jun1okamura/TR-1um_Async_I2C/script/test_i2c_slave_async.py

"""
Functional verification of i2c_slave_async using MyHDL's own event-driven
simulator (no external Verilog simulator available in this sandbox).

A minimal bus-functional master model drives SCL/SDA exactly like a real
I2C master (open-drain wired-AND on SDA) and runs:
  1. write transaction  : S, ADDR+W, ACK, DATA=0xA5, ACK, P
  2. read transaction    : S, ADDR+R, ACK, DATA (slave drives 0x3C), NACK, P
and self-checks addressing, ack/nack and byte values against UM10204
3.1.4-3.1.6.
"""

from myhdl import (Signal, intbv, delay, instance, block, Simulation,
                    traceSignals, StopSimulation, now)

from script.i2c_slave_async_model import i2c_slave_async, STATE_NAMES

SLAVE_ADDR = 0x50
T = 20          # half-bit-period-ish time unit (ns), value is irrelevant
                # for an async design - correctness must not depend on it.

errors = []


def check(cond, msg):
    if not cond:
        errors.append(f"[t={now()}] FAIL: {msg}")
    else:
        print(f"[t={now()}] OK: {msg}")


@block
def testbench():
    rst_n = Signal(bool(1))
    scl = Signal(bool(1))
    sda_master_oe = Signal(bool(0))   # master pulls SDA low when 1
    sda_slave_oe = Signal(bool(1))    # v3: slave pulls SDA low when 0 (active-low,
                                       # matches i2c_slave_async_model.py's sda_oe
                                       # port polarity, design_notes.md section 77.3)
    sda_line = Signal(bool(1))        # resolved open-drain bus value

    tx_data = Signal(intbv(0)[8:])
    rx_data = Signal(intbv(0)[8:])
    rx_valid = Signal(bool(0))
    addr_match = Signal(bool(0))
    rw = Signal(bool(0))
    busy = Signal(bool(0))

    dut = i2c_slave_async(rst_n, scl, sda_line, sda_slave_oe,
                           tx_data, rx_data, rx_valid, addr_match, rw, busy,
                           slave_addr=SLAVE_ADDR)

    @instance
    def bus_model():
        # open-drain wired-AND: line is LOW if either side pulls it low.
        # v3: sda_slave_oe is active-low (0 = slave drives), so it
        # contributes a "drive low" vote when it reads 0.
        while True:
            yield sda_master_oe, sda_slave_oe
            sda_line.next = not (sda_master_oe or (not sda_slave_oe))

    def send_bit(bitval):
        yield delay(T)
        scl.next = 0
        sda_master_oe.next = 0 if bitval else 1   # oe=1 => drive 0
        yield delay(T)
        scl.next = 1
        yield delay(2 * T)

    def recv_bit():
        yield delay(T)
        scl.next = 0
        sda_master_oe.next = 0    # release, let slave (or pull-up) drive
        yield delay(T)
        scl.next = 1
        yield delay(T)
        bit = 1 if sda_line else 0
        yield delay(T)
        return bit

    def send_ack(ack):
        # master, as receiver, drives ack(0)/nack(1)
        yield delay(T)
        scl.next = 0
        sda_master_oe.next = 1 if ack == 0 else 0
        yield delay(T)
        scl.next = 1
        yield delay(2 * T)
        scl.next = 0
        sda_master_oe.next = 0

    def send_byte(byte):
        for i in range(7, -1, -1):
            yield from send_bit((byte >> i) & 1)

    @instance
    def master():
        yield delay(5 * T)
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
