jun1okamura/TR-1um_Async_I2C/(commit log)

2026-08-04 非同期I2CスレーブRTLの実バグ2件を修正し、リポジトリを整理
    - src/i2c_slave_async.v: START/STOP検出のレースコンディションを修正。
    start_cond/stop_cond/scl_rise/scl_fallを独立したwire連続代入から
    always内のインライン評価に変更。同じscl/sda_inの変化で起動する
    wireとalwaysの間で評価順序が保証されず、iverilogでalways側が
    遷移前の値を読んでSTART/STOPを検出できないことがあった。
    - src/i2c_slave_async_tb.v: rst_nのリセットパルスが一度も
    発行されていなかったバグを修正。4-state Verilogでは全レジスタが
    Xで起動するため、リセット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
    [i2c_slave_async.v, i2c_slave_async_model.py, i2c_slave_async_tb.v]
2026-08-04 非同期I2CスレーブRTLをゲート合成可能なv2構成へ全面書き直し、Yosys合成と回路図生成まで実施
    - i2c_slave_async.v: 単一always構成（v1）をYosysが合成不能と判定したため、
    非同期SR部（DEL1遅延線+NOR2クロスカップルラッチでSTART/STOP検出）と
    SCL posedge/negedgeドメインのDFFR同期部に分離するv2構成へ書き直し
    - Yosys(yowasp-yosys)でTR1um_5_stdcellへ合成し、i2c_slave_async_net.v
    （33xDFFR+組合せ144セル、ラッチ推論なし）を生成。TR1um_5_stdcell.lib
    （プレースホルダLiberty）を新規追加
    - stdcell_behavioral_stubs.v追加によりiverilogでv2 RTL/netlistを
    シ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
    [i2c_slave_async_net.sch, i2c_slave_async_net_routed.sch]
2026-08-04 - TR1um_5_stdcell.lib の生成スクリプト gen_liberty.py を追加（セルごとの 面積/遅延/論理関数をテーブルで管理、既存libとバイト一致確認済み）
2026-08-05 高FOネットへのバッファ挿入(scl/sda_in/_126_/_127_を分岐×2)、テストベンチの レースコンディション修正、xschem/SPICE接続検証、KLayout配置の再生成を実施
    - fanout_rtl.py/fanout_net.py: RTL・ゲートレベル両方のファンアウト解析ツールを追加
    - insert_buffers.py: scl(BUF_X16x2)/sda_in(BUF_X2x2)/_126_(BUF_X4x2)/_127_(BUF_X2x2)
    を分岐バッファ挿入、i2c_slave_async_net.vを144→152インスタンスに更新
    - lvs_check.py: 新旧ネットリスト間の構造的接続検証ツールを追加
    - テストベンチのレースコンディションを発見・修正: send_bit/read_ack/read_byte/
    send_ack等でsclとm_oe(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
    [i2c_slave_async_net.sch, i2c_slave_async_net_routed.sch]
2026-08-05 上マージンチャネル(論理行3)パイロット配線: V1-GC DRC対応と隣接ピン競合対策
    - V1.GC間隔違反(実機KLayout DRC run.drcで検出、6件)を修正: abs_pin_anchor()の
    ビア安全領域計算にGCレイヤ立入禁止ゾーンの差し引きを追加
    - 隣接ピン(同一/近接インスタンス)によるM2エスケープ競合を8件→2件に削減:
    共有障害物検出+Union-Findグループ化、交互方向(L/R)強制割り当て、
    forced_rank/skip_rankによるオフセット競合回避、優先ネット処理順制御
    - 残り2件は既知の制約として記録(_find_jog_xの早期リターンが原因と特定、
    修正を試みたが密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
2026-08-05 残存2件の対処案としてXミラー反転を試行、効果なく不採用(design_notes.md §22.6)
    - _400_(NOR4)のA pinをXミラーで移動させ短絡回避を試みたが、DRC(M1間隔)違反
    2件が新規発生し、接続検証の短絡疑いも2件→4件に悪化
    - 事前検討でNAND2/AND2_X1/NOR4のA/B(/C/D)ピンがセル内で同一X座標である
    ことをライブラリGDSから確認: 同一インスタンス内競合(_404_等)はXミラー
    では原理的に解決しないことを裏付け
    - 試行はrevert、gen_gds_placement.py・配置GDSはコミット済み版と一致することを確認
    - パイロット配線GDSはDRCクリーン・残存2件の既知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
2026-08-05 同一X pin(A/B縦積み)の強制ジョグ前処理を実装、_404_の短絡を解消(design_notes.md §22.7)
    - 全ピンをX座標で完全突き合わせし、同一Xのペア(_404_/_410_/_430_の各A/B、
    NAND2/NOR4系ゲートの縦積み入力ピンでライブラリ設計上X完全一致が確定)を
    must_jogとしてマーク
    - _find_jog_xに must_jog 引数を追加、該当ピンは「既にクリア」の早期リターン
    を無条件スキップし必ず実ジグザグ探索を行うよう修正
    - §22.5で悪化したpreferred_dir全体への適用と異なり、完全同一X(衝突が数学的
    に確実なケース)のみに範囲を絞ったため副作用なし(DRC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
2026-08-05 論理行0・行1/2共有チャネルの行内配線を実施(design_notes.md §23)
    - route_channel_pilot.pyを汎用化したroute_channel.py(route_row_channel)を
    新設: phys_row_index/mirrored/channel位置/escape_dirをパラメータ化
    (論理行1/2は電源レール共有のためY反転配置、将来の共有チャネル対応を
    見据えmirrored=Trueのピン座標変換(M0)にも対応)
    - 論理行3で回帰チェック(既存パイロットと完全一致)後、論理行0を配線
    (26ネット、DRCクリーン、接続検証残存3件)
    - 一般化作業中、初期スキャンと再スキャンでM2障害物スキャン範囲が
    不一致というバグを発見・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
2026-08-05 FM法による配置最適化でクロス行ネットを73%削減、配置を再生成(design_notes.md §23.5,24)
    - 行をまたぐネットの分析: 107本(電源除く)、うち配線困難なギャップ0境界
    (行0↔1、行2↔3)を含むものが67本と判明
    - route_cross_row.py: ギャップ0境界向けの新配線方式(M2連続シェイプ)を
    試作するも失敗率43%・新規短絡4件と不十分と判明(否定的結果、
    出力GDSはLayout/へコミットせず)
    - plan_placement.pyにFiduccia-Mattheyses法による階層的ハイパーグラフ
    最小カット分割を実装: {行0+1}vs{行2+3}(実チャネルのある行1↔2境界に
    カットを誘導)→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
2026-08-06 FM分割の決定性バグ修正、チャネル高さ拡大、フォールバック汚染バグ修正
    - plan_placement.py: _fm_bipartition()のセット反復をsorted()に変更し
    プロセス間の非決定性を解消(list(set)がハッシュランダム化の影響を受けていた)
    - gen_gds_placement.py: FM最適化後の配置密度に合わせてPHYSICAL_ROWSの
    チャネル高さを拡大(行3上マージン2→4行,行1/2共有3→7行;物理構造の
    シーケンスは維持,行1/2側は奇数を維持してミラー偶奇を保存)
    - route_channel.py/route_channel_shared.py: ROW3_PILOT/ROW12_SHAREDの
    phys_row_index等を新配置に追従。ジョグ探索失敗時に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
2026-08-06 ミラー配置廃止・5行チャネル方式への全面再設計
    物理構造を「配線+スタセル1段+配線」の単位を縦に5個積む方式に変更し、
    上下ミラー配置を全廃(design_notes.md section 26)。旧4行構造では
    行0/行1・行2/行3がゼロギャップのミラー隣接ペア(電源レール共有)で、
    このゼロギャップ境界を跨ぐ配線が最後まで未解決の課題だった
    (route_cross_row.pyの試作は失敗、FM配置最適化でも回避しきれず)。
    新構造は全ての行境界を実M1チャネルにすることでこれを根本解決。
    - plan_placement.py: NROWS=4→5。compute_rows()にnrows==5用の5行
    チェーン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
2026-08-06 6チャネル統合レイアウトを生成、チャネル間の見落とし衝突を修正
    ユーザー要望で全チャネルを1つのGDSにまとめて出力するにあたり、
    各チャネルが独立に配置のみGDSを読んで配線していたため、同じ行を
    挟む隣接チャネル同士が互いの配線結果を見ずに配線し、統合すると
    M2違反19件・ショート疑い52件相当に悪化する問題を発見(design_notes.md
    section 26.8)。
    route_channel.py/route_channel_shared.pyにin_gds引数を追加し、
    route_all_channels.pyで6チャネルを物理的な並び順に逐次配線するよう
    変更: 各チャネルは直前のチャネルの累積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
2026-08-06 上下ミラー配置を全物理行に復活(ウェル系DRC対策)
    ユーザーが実KLayout DRCデックで多数のエラーを確認。§26で「ミラーは
    ゼロギャップ境界の電源レール共有専用で実チャネル方式には不要」と
    判断したのは誤りで、Nウェル/Pウェルのバンディングも上下ミラー交互
    配置を前提にしていた。本セッションの簡易DRCチェックスクリプトは
    M1/M2/V1のみでウェル/タップ層を見ていなかったため検出できていな
    かった。このサンドボックスにはklayout DRC DSLランタイムが無く
    run.drcを直接実行して確認することはできないため、ユ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
2026-08-06 実DRC結果に基づきV1-CO違反を解消、M2違反を7→3件に削減
    ユーザーが実KLayout DRC(tech/drc/run.drc)を実行し、DRC_Error.lyrdb
    を共有。実エラー15件(M2最小間隔違反7件=既知パターン、V1-CO重なり
    8件=簡易チェックスクリプトが検証していなかった新種)に対応。
    - route_channel.py/route_channel_shared.py: via anchor探索にCO層
    (11/0、poly/diffusion-M1間コンタクト)回避を追加(既存のGC層回避と
    同じ仕組み)。V1-CO重なり・1.0um未満分離とも0件に。
    - 同上: ネット単位で一括描画していたのをピン単位でインターリーブ
    (描画直後に_existing_m2を更新)す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
2026-08-06 未配線ピン(88件)解消の試行: 2ベンドZシェイプジョグ実装、根本原因を特定
    route_channel.py/route_channel_shared.pyに2段ベンド(Zシェイプ)の
    ジョグフォールバックを実装。単一ベンド(L字)探索が失敗した場合、
    ピン→トラック間の中間Y(5分割点)でローカル退避→フルレンジ探索の
    2段構えを試す。_find_jog_xを_find_jog_x_range/_find_jog_pathに
    一般化し、ピン単位描画ループを任意長ウェイポイント列に対応させた。
    検証の結果、Zシェイプ経路は1件も使われず、オープン件数は88件の
    まま変化なし。原因を実際の失敗ピン座標とM2形状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
2026-08-06 チャネル振り分けをネット数ベースの貪欲バランスに変更(ch4_tm偏り修正)
    route_all_channels.pyの同一インスタンスグループの割当を、グループ
    個数での交互round-robinから、グループをネット数の多い順にソートし
    逐次少ない方のチャネルへ割り当てる貪欲バランスに変更。
    原因: 論理行4の行内完結ネット45本がUnion-Find(同一インスタンス
    共有による推移的結合)でわずか5グループに収束し、うち1グループが
    37本(82%)を占めていた。グループ"個数"で交互割当していたため、
    この巨大グループが偶数番目(ch3_4側)に丸ごと入り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
2026-08-06 2パス方式のvia anchor予約を実装、M2スペース違反が初めて0件に
    route_channel.py/route_channel_shared.pyに、配線開始前に全ピンの
    via/pad アンカー位置を予約する2パス方式を実装。ジョグ探索の障害物
    判定に、実際に描画済みのM2形状(_existing_m2)に加えて全ピンの予約
    領域(自分自身は除外)を含めるようにし、先着ネットのジョグ経路が
    後続ピンの設置場所を塞ぐことを未然に防ぐ(section 29.4で診断した
    資源競合の根本原因への直接対処)。
    結果: M2スペース違反 4件→0件(section 22.5以来初めて0件を達成)。
    未配線ピンは89→86件と小幅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
2026-08-06 アンカー予約のチャネル横断グローバル化を試行、悪化のためロールバック
    route_channel.py/route_channel_shared.pyの予約対象を、チャネルが
    実際に配線するネットのピン(net_stub_pts)から、行内の全インスタンス
    の全ピン(allowed_netsに関係なく)へ拡張し、チャネル間の見落とし
    衝突(§31残課題の23/86件=27%)の解消を試みた。
    結果、未配線ピンが86→104件に悪化(M2違反は0件を維持)。予約範囲を
    無関係なネットのピンまで大幅に広げたことで、多くのジョグ経路が
    新たに塞がれてしまい、狙った27%の改善を副作用が上回った。
    §31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
2026-08-06 マルチホップネット(15件)向けの最終配線パスを新規実装(route_multihop.py)
    3行以上/非隣接行にまたがりチャネル配線では扱えない15件のマルチ
    ホップネットに対応する新規スクリプトroute_multihop.pyを追加。
    統合済みレイアウト(i2c_slave_async_layout_routed_all.gds)を読み
    込み、各ネットのピンをY順に並べてM2チェーン配線する最終パス。
    単純なエルボー/Zシェイプは100%失敗(チップ全体スケールでは単一
    ベンドが経路上のどこかで必ず衝突する、section 29と同種の限界)。
    15ネット・約100セグメントに限定範囲であることを踏まえ、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
2026-08-06 未配線86ピン・15ネットの詳細レポートとERRレイヤー可視化を追加
    script/gen_err_report.pyを新規実装。route_all_channels.py/
    route_multihop.pyのログから未配線項目を抽出し、以下2点を生成:
    1. Layout/unrouted_report.txt: チャネル内オープンピン86件
    (net名・instance.pin・座標)とマルチホップ未配線セグメント91件
    (net名・対象行・区間・座標)の一覧テキスト
    2. Layout/i2c_slave_async_layout_with_err.gds: メインの
    routed_all.gdsとは別のレビュー用コピーに、ERRレイヤー
    (252/0=チャネルオープンピン、252/1=マルチホップ未配線区間の
    端点・接続線)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
2026-08-07 FO=1ネットのクラスタ配置を実装、単一行構成での効果判定実験を実施・記録
    - plan_placement.py: FO=1(受信ピン1個)ネットの出力/入力セルを
    Union-Findでクラスタ化(上限4)、FM分割・行内順序で常に隣接配置
    されるようにした。クラスタ化に伴いFM容量スラックを1.28→1.05に
    再チューニング。
    - route_all_channels.py: 同一インスタンスUnion-Findグループに
    上限を追加できるSAME_INST_GROUP_CAP機構を追加(本番5行では
    9999=実質無効、単一行実験でのみ16を使用)。
    - 5行構成での結果: チャネルオープン86→42(改善)、マルチホップ
    15→34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
2026-08-07 FILLコリドー除去テストと6行構成試行を記録
    - plan_placement.py: FM分割のnrows!=4,5フォールバックを、汎用的な
    再帰チェーン分割(split_chain)に置き換え。nrows=1(単一行実験)を
    特殊ケースとして自動的に正しく処理しつつ、nrows=6のような任意の
    行数にも対応。
    - gen_gds_placement.py: distribute_row_fillers()にNO_CORRIDORS
    トグルを追加(コリドーなし比較用)、USE_6ROWトグルで6行チェーン
    構造(PHYSICAL_ROWS_6)を再現可能に。どちらも未設定時は本番の
    5行構成に影響なし。
    - 単一行構成でのFILLコリドー効果確認: コリドーありオープン83件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
2026-08-07 チャネル内オープン42件の原因内訳を調査・記録
    - route_channel.py/route_channel_shared.pyにROUTE_DEBUG_CAUSE=1で
    有効化される診断コードを追加。失敗ピンごとに(1)自分のアンカーが
    既存M2/2パス予約で塞がれているか、(2)塞がれていない場合は
    ピン→トラック間の垂直経路のどこが塞がれているかを2um刻みで
    スキャンして報告する。デフォルト無効、本番動作に影響なし。
    - 42件中16件(38%)はアンカー自体が既存M2と衝突(§29.4と同じ
    パターン)、26件は別要因と分類。診断の結果、この26件は例外なく
    「アンカーはクリアだ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
2026-08-07 オープンピン/未接続ネット/接続先をレイヤー分離したERR可視化を追加
    - script/gen_err_report2.py: 最終統合GDSから全196ネットの実接続性を
    M1/V1/M2のUnion-Findで直接再構築し(ログパースではなく)、ネット単位
    で分類:
    - (252,0) オープンピン: ネットは部分的に接続済みだが繋がって
    いないピン。接続先(252,2)は同ネットの本体側最近傍ピン。
    - (252,1) 未接続ネット: ネット内のどのピアも一切繋がっていない
    ネット全体のピン。接続先(252,2)は同ネット内の最近傍ピン。
    - (252,2) 接続先マーカー+接続線(両カテゴリ共通)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
2026-08-07 route_multihop.py: fix pad-drawing to check M2 clearance + guarantee V1-M1 enclosure on offset
    - touched-pin via/M2-pad drawing now checks clearance against a
    per-net snapshot of other nets' M2 (_other_nets_m2) before drawing,
    with a small local-offset retry (0.5-4um) before giving up and
    leaving a pin open (logged as WARNING). Previously drawn
    unconditionally with zero clearance check -- latent bug exposed by
    the 6-row+always-fill trial (6/7 new M2 violations).
    - fix attempt 1 (checked against the live, continuously-updated
    _existing_m2) had a false-positive problem: it also flagged a pin's
    pad as 'colliding' with its own net's just-drawn trunk (intentional
    overlap), causing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
2026-08-07 design_notes.md: document V1-M1 bug fix and 6-row width sweep (section 34.9-34.11); restore production layout regen
    - section 34.9: FILL-always + width-relaxation trial on 5-row
    (2200um: 31 opens/DRC=1, better than 2050um's 31 opens/DRC=9)
    - section 34.10: full root-cause writeup of the route_multihop.py
    unconditional pad-drawing bug, fix attempt 1's false-positive
    regression, fix attempt 2's correct snapshot-based approach, and
    the V1-M1 enclosure violation it initially introduced (offset pads
    need their own M1 guarantee-pad -- the original abs_pin_anchor()
    enclosure guarantee only holds at the pin's un-offset anchor)
    - section 34.11: 6-row + always-fill width sweep with the cor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
2026-08-07 6行+FILL常時挿入(ROW_WIDTH_UM=2075)を作業ツリーに反映しレイアウト確定・ERR可視化
    - plan_placement.py/gen_gds_placement.pyを6行/2075um版に切替
    (5行本番/1800umはコミット履歴6368b13/eb3d17cに保持、必要なら
    そちらのファイルへ戻して再生成すれば復元可能)
    - 全パイプライン再生成 (PYTHONHASHSEED=0, USE_6ROW=1):
    チャネル内オープン29、マルチホップ 0完全/11部分/19完全失敗
    DRC完全クリーン (M1/M2/V1 全項目 viol=0)
    - gen_err_report2.py: 真の接続性再検証
    オープンピン82・未接続ネット120ピン(38ネット)、合計202
    (5行本番の236より良好)
    - gen_err_repor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
2026-08-07 route_multihop.py: switch to M1-in-channel routing model (design_notes.md section 34.12)
    Per user request: inter-cell connections must switch to M1 in the
    channel region before connecting, instead of running M2 directly
    across cell rows.
    - vertical moves: always M2 (crossing a cell row, no electrical
    overlap so no via needed against that row's own M1)
    - horizontal moves: only legal, and only ever drawn, on M1, and only
    while inside a channel band (a filler-only physical row) -- mirrors
    the channel routers' own M1-trunk-at-track-height convention,
    generalized across multiple channels
    - every interior bend in the simplified path is now a genuine M1<->M2
    transition and gets a real vi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
2026-08-07 route_multihop.py: refine M1-channel-switch to FILL-gap-limited M2 (design_notes.md section 34.13)
    Per user refinement: M2 may run horizontally, outside a channel band,
    only as far as the FILL slot immediately next to a cell -- never
    directly over another real cell. Longer connections must go M2
    vertical -> M1 horizontal in a channel band (section 34.12's rule),
    same as before.
    - computed every real (non-filler) cell's absolute X extent from the
    placement data, and the inter-cell FILL gaps between consecutive
    cells in each row (_cell_x_extent, _gap_ranges_by_row)
    - new _h_leg_layer(y, x0, x1): 'M1' if y is in a channel band, 'M2' if
    y is in a cell row and the whole [x0,x1] span stays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
2026-08-07 gen_gds_placement.py: halve underutilized channels ch0_1/ch2_3/ch3_4 (design_notes.md section 34.14)
    Per user observation, route_all_channels.py's own track-usage report
    (section 34.13's 1700um config) showed ch0_1/ch2_3/ch3_4 using only
    7/32, 5/32, 7/32 track slots respectively -- well within a halved
    16-slot budget. ch1_2 (20/32) and ch4_5 (16/32) are used closer to
    capacity and were left at 4 filler rows.
    Result: core height 1650um -> 1320um (-20%), but with a quality
    regression: segments 0/15/15 -> 0/13/17, DRC violations 2 -> 6
    (M1:5,M2:1), true connectivity 195 -> 199. Traced 3 of the 5 new M1
    violations to ch1_2 (a channel whose height was NOT changed) --
    apparently a knock-on effect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
2026-08-07 route_multihop.py: fix unchecked bend-via guarantee-pad placement (design_notes.md section 34.15)
    Per user hypothesis that the M1 space violations came from a
    2um-vs-4um M1 width mismatch between route_multihop.py's legs and the
    channel routers' trunks: investigated the actual violation geometry
    and found the real cause is more direct -- the M1<->M2 layer-
    transition guarantee pad (3.4x3.4um, introduced in section 34.12) was
    drawn completely unconditionally, with no clearance check against
    existing M1 at all, unlike every other pad-drawing site in this
    project (same class of oversight as section 34.10's touched-pin pad
    bug). The pad's own width (3.4um, wider than the 2um leg) made it
    more li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
2026-08-07 route_channel.py/route_channel_shared.py: fix unchecked pin-pad placement (design_notes.md section 34.16)
    Investigated the last remaining M2 violation (x=436,y=562-570) and
    found it predates route_multihop.py entirely -- confirmed via GDS
    diff that all 3 colliding shapes already existed right after
    route_all_channels.py, before route_multihop.py ran at all.
    Root cause: same bug class as sections 34.10/34.15, but in the
    channel routers this time. Each pin's own M2 pad is drawn at a FIXED
    position (the pin's physical location) completely unconditionally --
    the jog PATH is clearance-checked via _find_jog_path, but the pad
    itself is not automatically covered by that search (a neighboring
    pin's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
2026-08-12 design_notes.md: record next-gen stdcell/routing-channel grid policy (section 35)
    Captures the architectural direction discussed for the standard cell
    library redo, based on the user-supplied TR-1um_DRC_summary.pdf:
    - Cell height quantized to 5.4um (shared with M2 vertical track
    pitch), cell width = 5.4um x pin count with one dedicated X track
    per signal pin (no shared X).
    - Channel grid: X=5.4um (M2), Y=4.0um (M1 trunk pitch).
    - All dimensions verified against this project's established DRC
    minimums (M1 1.8/1.4, M2 3.0/2.0, via 1.4, enclosure 1.0) -- the
    via/pad math (1.4 + 2x1.0 = 3.4) already matches route_channel.py's
    existing VIA_SIZE/M2_PAD_SIZE constants exactly.
    - VDD/GND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
2026-08-13 design_notes.md + LEF/script: record next-gen stdcell implementation progress
    - design_notes.md section 35.6: implementation decisions confirmed
    while prototyping INV_X1 -- no row mirroring (replaced by
    channel-cell-channel sandwich placement), via/M2 pads baked into
    the cell but not extended into a full vertical pass-through
    (pin position is computed from the LEF offset table, not searched,
    so no pass-through is needed), and the pin marker layer split into
    M1PIN (48/1) / M2PIN (49/1) to resolve the ambiguity found when a
    single generic 'pin' layer would otherwise mark both the M1 VDD/GND
    rail and an M2 signal pad at overlapping coordinates.
    - design_notes.md section 35.7: sc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
2026-08-13 gen_lef.py: add DFFR pin metadata; regenerate LEF with 14/17 cells
    DFFR GDS added by user (SIZE 64.8x64.8um, matches section 35.8's
    20-transistor TG-based design: D/CK/RST inputs, Q/QB outputs, all on
    M2, CK marked USE CLOCK). Verified clean against the same DRC/pin
    coverage checks used for the other 13 macros (M1/M2 width+space, V1
    enclosure+space, pin-marker-vs-real-geometry coverage) -- all zero
    violations. LEF now covers 14 of the 17 cell types used in the
    synthesized netlist; only BUF_X2/X4/X16 remain.
    design_notes.md section 35.7 updated with DFFR's verification result
    and the shrunk remaining-cells table.
2026-08-13 gen_lef.py: alias BUF_X2/X4/X16 to BUF_X1's physical cell; LEF now covers all 17 cell types
    User drew BUF_X1 and decided not to draw separate physical cells for
    BUF_X2/X4/X16 for now -- substitute BUF_X1's layout for all of them.
    Implemented via LEF's FOREIGN mechanism (MACRO name can differ from
    the GDS structure it references): MACRO BUF_X2/BUF_X4/BUF_X16 each
    declare FOREIGN BUF_X1, so P&R places BUF_X1's real geometry under
    each of the three logical names without any netlist changes. Verified
    BUF_X1 itself clean against the same DRC/pin-coverage checks used for
    every other cell.
    Flagged in code + design_notes.md section 35.7: gen_liberty.py's
    COMB_CELLS table still only defines BUF_X1's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
2026-08-13 gen_lef.py: support multi-fragment pins; add TAP2/TAP3 power tap cells
    User drew TAP2/TAP3 (section 35.3/35.9 power tap cells): no signal
    pins, just VDD/GND, each with an M1 rail plus an M2 strap that runs
    the cell's FULL height (unlike signal pins' local pads) so either an
    above or below channel can contact it -- via only at one end per net
    (GND via at the bottom, VDD via at the top), with the strap merely
    passing over the other net's M1 rail with no via (different layers,
    no short, matches how M1/M2 always stack elsewhere in this design).
    This produced pin geometry split across multiple disjoint marker
    polygons (1 M1 rail + 2 M2 endcaps per net) mapping to the same pin
    name for the first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
2026-08-13 gen_lef.py: add FILL2/FILL3 wider filler cells
    User drew FILL2 (2-track, 10.8um) and FILL3 (3-track, 16.2um) filler
    cells -- addresses the earlier stdcell-library critique that a single
    fixed-width FILL1 always leaves leftover gaps at row ends. VDD/GND M1
    rail only, no M2/via, same role as FILL1. Added PIN_META entries and
    regenerated; reran the full DRC/pin-coverage sweep across all 19
    physical cells (no regressions) plus the 3 BUF_X* aliases -- 22 MACRO
    total, all clean.
    design_notes.md section 35.10 records this.
2026-08-13 Section 37: 2-row P&R trial (placement, 3-channel routing, DRC clean, known long-stub short limitation)
    - gen_placement_2row.py: simple cumulative-width net split into row1/row2,
    TAP-first placement with shared X grid across both rows (guarantees equal
    row widths and vertically-aligned TAP columns)
    - estimate_channel_tracks_2row.py: 3-channel (bottom margin / shared middle /
    top margin) track estimate; confirms cross-row nets (76, peak 56) force the
    middle channel to ~4-19x the size of either margin channel
    - gen_placement_gds_2row.py: 3-channel-band placement GDS
    - route_channels_2row.py: channel router extended to 2 rows / 3 channels,
    cross-row nets forced into the shared middle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
2026-08-13 Section 37.6: FM min-cut row partitioning, cuts long-stub shorts 28->7
    - fm_partition.py: classic Fiduccia-Mattheyses hypergraph bipartitioning
    (nodes=instances weighted by cell width, hyperedges=nets), width-balanced
    (+-5%), seeded from the naive cumulative-width split. Cut nets 78->16 in
    4 passes, <1s runtime.
    - gen_placement_2row_fm.py, gen_placement_gds_2row_fm.py,
    route_channels_2row_fm.py, drc_check_2row_fm.py,
    verify_connectivity_2row_fm.py: FM-partitioned variants of the section-37
    pipeline (naive-split versions kept as-is for comparison).
    - Result vs naive split: cross-row nets 76->14 (peak 56->7), middle channel
    73-86->49-53 tracks, DRC still clean, and critically the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
2026-08-13 INV_X1: update transistor-level geometry (user edit)
    M1/M2/PIN/PR layers unchanged (LEF regenerated, byte-identical to
    previous), so this only affects layers below the LEF abstraction
    (poly/diffusion/etc). Verified DRC-clean (M1/M2/V1: 0 violations),
    pin markers fully covered and correctly labeled.
2026-08-13 4-row FM-partitioned P&R trial with distributed FILL and N-channel router
    - fm_partition.py: add fm_multiway_partition() (recursive bisection,
    power-of-2 rows) and classify_multirow_nets() for row-only/
    adjacent-pair/spanning net classification.
    - gen_placement_nrow_fm.py: 4-row TAP-first placement using the
    multiway FM partition; FILL2/FILL3 now spread across each TAP gap
    (pack_row_distributed) per user request, for use as M2 routing
    corridors. Row width 1436.4um (under the 1700um target).
    - estimate_channel_tracks_nrow_fm.py, gen_placement_gds_nrow_fm.py:
    5-channel (bottom/ch1/ch2/ch3/top) track estimate and placement GDS.
    Core bbox (0,0)-(1436.4,893.2).
    - route_channels_nrow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
2026-08-13 Fix split_fill_evenly bug; re-run 4-row placement with corrected LEF
    split_fill_evenly's single-pass borrow-to-fix-a-1 logic could shove a
    stray 1-track part past an already-visited index and never revisit it
    (confirmed: 3 tracks / 7 slots produced [0,2,0,0,0,1,0]). Since
    fill_combo(1) is None and the caller did `fill_combo(x) or []`, that
    1 track silently vanished -- one row ended up 5.4um narrower than the
    others with no error, only caught by the row-width-equality assert
    firing on an unrelated re-run. Rewrote using a direct construction
    (only ever as many active >=2-track slots as total_tracks supports)
    that cannot produce a 1 in the first place, and hardened the call site
    to assert inste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
2026-08-13 route_channels_nrow_fm.py v3: via_1 PCell, grid-aligned jogs, TAP power mesh
    User-directed rework of the v2 spanning-net routing mechanism:
    - Every via (pin connections, trunk vias, and the new jog vias) is now
    a via_1 PCell instance (TR-1um library) instead of hand-drawn raw
    boxes on M1/V1/M2.
    - Spanning nets: M2 stays strictly vertical at all times. X changes
    happen via via_1(M2->M1) -> M1 horizontal run -> via_1(M1->M2)
    within a channel, replacing v2's wide M2 "sweep box" jog.
    - Grid discipline: jog X candidates step in exact 5.4um increments
    from an on-grid start (a real pin's own X); jog M1 runs always land
    on the channel's existing 4.0um track pitch, using the SAME shared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
2026-08-13 nrow_fm: fix row width to 5.4x300=1620um, left-edge FILL, row stagger, out-of-bounds fix
    - gen_placement_nrow_fm.py: TAP_INTERVAL_TRACKS now derived from a
    fixed TARGET_ROW_WIDTH_UM=1620.0 (was content-dependent 1436.4um).
    pack_row_distributed() now includes insertion position 0, so FILL
    is placed at the left edge of every gap (previously never before
    the first real cell). New STAGGER_TRACKS=[0,2,4,6] forces extra
    leading FILL per row, giving each row's real-cell sequence a
    different absolute X start (27.0/32.4/43.2/54.0um) as a placement-
    only mitigation for the known case-2 short pattern.
    - route_channels_nrow_fm.py: added ROW_WIDTH_UM constant + assertion
    matching the pla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
2026-08-13 Add gen_err_report_nrow_fm.py: ERR-layer highlight of shorts + unconnected pins
    New non-fab layers on i2c_slave_async_nrow_fm_with_err.gds:
    (253,0) ERR_SHORT_GEOM: actual merged M1/M2/V1 geometry of every
    connectivity component shared by >1 net (the literal shorted wire).
    (253,1) ERR_SHORT_PIN: marker+label at every pin of every net
    implicated in one of the 23 shorts, so both nets can be traced.
    (253,2) ERR_UNCONNECTED_PIN: marker+label at every stub net's pin
    (net with <2 M2 pins, never touched by the router). Labeled
    PORT: for the 7 that are top-level module ports (expected -- other
    end is off-chip) vs OPEN: for the 24 that are not (worth a closer
    look next se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
    [gen_err_report_nrow_fm.py]
2026-08-14 nrow_fm: left/right anchored FILL packing by row parity (case-2 mitigation)
    gen_placement_nrow_fm.py: pack_row_distributed() now takes anchor=
    "left"/"right". Even rows pack real cells contiguously right after
    each gap's leading TAP (slack FILL trails); odd rows pack real cells
    contiguously up to each gap's next TAP (slack FILL leads). Gaps are
    consumed in reverse order for right-anchored rows so a row's real
    content concentrates at the row's true left/right end (not just
    gap-0's local end) -- an earlier version of this that consumed gaps
    in row order barely moved the overlap numbers, see design_notes 38.7
    for the bug and fix. Replaces the old STAGGER_TRACKS + insert_period
    distributed-FILL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
2026-08-14 nrow_fm v4: high-FO track isolation + per-row local trunk for 4 named nets
    route_channels_nrow_fm.py:
    - High-FO nets (>=8 pins, HIGH_FO_THRESHOLD) pulled out of normal lane
    assignment into a dedicated, guarded (HIGH_FO_GUARD_TRACKS empty
    tracks on either side) track region at the front of their channel,
    processed first. Closes the gap where collides()/claim_track() only
    check discrete registered pin X's, not a wide trunk's continuous
    X-span, against nearby tracks.
    - scl_buf0/scl_buf1/_126_buf0/_126_buf1 (user-named, highest fan-out,
    multi-row nets) get a different, more thorough treatment per user
    request: PER_ROW_LOCAL_NETS -- each row with pins gets its own LOCAL
    M1 trunk i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
2026-08-14 design_notes.md: document section 38.8 (case-2 deep-dive + 3-pronged fix)
    Documents: the two root causes found (separation-budget overshoot for
    all 3 adjacent row pairs; high-fan-out buffer-tree nets acting as
    transitive short "hubs" via wide trunks), the three countermeasures the
    user directed (high-FO dedicated+guarded tracks, per-row local trunk +
    spine for the 4 named nets, scoped overlap-zone live-check), the two
    real bugs found and fixed during implementation (M1-layer false
    positives in the live checks; spine landing X not matching the
    destination trunk's own X-range, causing NET SPLIT), and the final
    decision (keep the overlap-zone check implemented but disabled --
    `overlap_zone = {}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
2026-08-14 nrow_fm: reposition per-row-local trunks to near-row side of channel
    The 4 named per-row-local nets (scl_buf0/scl_buf1/_126_buf0/_126_buf1)
    were placed at the low-idx (channel-bottom, far-from-row-c) end of
    each channel's dedicated track block. Since track_y increases with
    idx and channel c sits directly below row c, the correct near-row
    side is the HIGH-idx end. Reordered per_row_track_of to be allocated
    after the normal Pass-1 blocks, with an explicit leading guard track
    at the new boundary.
    Result: DRC still 0 violations; connectivity shorts dropped 22->8 by
    breaking a large union-find short chain that had been hubbing through
    these 4 nets' M2 stubs. See design_notes.md 38.9.
2026-08-14 gen_err_report_nrow_fm: pinpoint exact short-overlap polygons
    Add ERR layer (253,3): for each shorted net pair, reconstruct each
    net's own M1 trunk + M2 stub geometry independently from
    pin_map/placement data (the merged GDS region can no longer tell
    which polygon area belongs to which net once two nets' copper has
    physically fused) and intersect the two nets' regions to get the
    exact overlap polygon(s), instead of highlighting the whole
    (potentially chip-spanning) shorted net component.
    6/8 shorts pinpointed exactly; the remaining 2 involve per-row-local
    spine jog segments not yet reconstructed, and still fall back to the
    existing (253,0) whole-blob highlight. Text report now lists overlap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
    [gen_err_report_nrow_fm.py]
2026-08-14 route_channels_nrow_fm: log per-net drawn shapes for exact short analysis
    Add a net_shapes_nrow_fm.json dump: every M1/M2 box drawn during
    routing is now tagged with the net being routed at draw time (cur_net
    set at the top of each per-net loop in passes 0/1/2). This is ground
    truth, unlike reconstructing stub/trunk geometry from pin_map after
    the fact -- it also captures jog/spine dogleg segments.
    gen_err_report_nrow_fm.py now prefers this log for its (253,3)
    short-overlap pinpointing, falling back to the old pin-based
    reconstruction if the log is missing. Result: 8/8 shorts now
    pinpointed to an exact overlap polygon (previously 6/8). The 2
    previously-unresolved shorts (_126_buf0/_115_, _1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
    [gen_err_report_nrow_fm.py]
2026-08-14 nrow_fm: targeted jog pass for 6 pinpointed case-2 shorts (v4.3)
    Add FORCE_JOG_NETS = {txreg[1], _195_, _055_, _059_, _172_, _109_} --
    the lower-fan-out side of 6 case-2 shorts pinpointed in 38.10/38.11.
    These nets are pulled out of the normal pass-1 pool and drawn in a
    dedicated pass run after everything else, reusing the existing
    forced-overlap-zone machinery (channel_clear/find_channel_clear_x/
    draw_jog from 38.8) but applied unconditionally to just these 6 named
    nets instead of a whole zone -- keeping jog count and area cost small
    (17 pins jogged) where applying the same check to an entire zone
    previously cost 176 jogs / +71% core height (38.8) and a targeted
    spine live-check fix attempt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
2026-08-14 nrow_fm: add scl_n to per-row-local independent-trunk nets (v4.4)
    Per user request, scl_n joins scl_buf0/scl_buf1/_126_buf0/_126_buf1 in
    PER_ROW_LOCAL_NETS. Since the classification loop checks
    PER_ROW_LOCAL_NETS membership before the high-FO check, this required
    only a one-line constant change -- scl_n (10 pins) is no longer
    treated as a single-shared-trunk high-FO net and instead gets its own
    per-row local trunk + spine, same as the other 4.
    Result: DRC still 0 violations. scl_n's own shorts (scl_n/_126_buf1,
    scl_n/_080_) resolved, but its new spine crossing collides with
    bit_cnt[2] at a different X, and one unrelated bit_cnt[1]/_115_ short
    also appeared (structural track-offset side effe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
2026-08-14 nrow_fm: fix draw_jog departure-leg exposure, add (253,4) jog-highlight layer (v4.5/v4.6)
    - claim_track_near(): search outward from a target track index instead
    of always taking the next never-tried global index.
    - draw_jog(near_y=...): use claim_track_near anchored at channel_entry_y
    so the jog's unchecked departure leg (vertical run at the original X,
    from cur_y up to jog_y) stays as short as possible instead of spanning
    almost the whole channel when FORCE_JOG_NETS (which runs last in the
    pipeline) claims a far-away track.
    - force_jog_events log + (253,4) ERR_FORCE_JOG layer in
    gen_err_report_nrow_fm.py: highlights every FORCE_JOG_NETS jog's M1
    run + via endpoints, so jog pla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
    [gen_err_report_nrow_fm.py]
2026-08-14 nrow_fm: add per-net ERR-layer highlight for priority (dedicated-track) nets
    New gen_priority_net_highlight_nrow_fm.py: separate review GDS
    (i2c_slave_async_nrow_fm_priority_err.gds) highlighting the 7 nets
    given dedicated guarded tracks + routed first (2 high-FO: _070_,
    _073_; 5 per-row-local: scl_buf0/scl_buf1/_126_buf0/_126_buf1/scl_n),
    one ERR layer (254,i) per net from net_shapes_nrow_fm.json ground
    truth, with net-name labels on every M1 trunk (channel-track) segment,
    so their channel/track occupancy can be inspected independently of the
    short/jog-focused (253,x) report.
2026-08-14 nrow_fm: consolidate Pass 0 spine crossings onto each net's own dedicated track (v5)
    User finding: PER_ROW_LOCAL_NETS' spine (row-crossing) segments reused
    the generic claim_track pool for every channel crossed, even channels
    where the net already owned a dedicated per-row-local track --
    wasting 1-2 extra tracks per channel per net (e.g. _126_buf0 alone
    used 2-3 tracks in a channel where it only needed 1).
    - per_row_channels_of: reserve one track per net in EVERY channel its
    spine crosses (pins + pass-through), not just channels with pins.
    - Pass 0 spine loop rewritten: row-body crossing still uses the
    existing live-checked find_row_clear_x; landing on the next
    channel's track is now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
2026-08-14 nrow_fm: add bit_cnt[2] to FORCE_JOG_NETS (v5.1) -- shorts 4->3
    User asked to categorize the remaining 4 shorts and investigate (1)
    whether the 3 'priority-net crossing' shorts (_126_buf0/_115_,
    _126_buf1/_080_, scl_n/bit_cnt[2]) can be added to the jog mechanism,
    and (2) why _055_/bit_cnt[1] still isn't resolved despite _055_ already
    being in FORCE_JOG_NETS.
    (1): root cause is that Pass 0 (per-row-local trunk+spine) runs first
    and its live checks only see geometry drawn so far -- it can't avoid a
    not-yet-drawn net's pin. Adding the 3 nets to FORCE_JOG_NETS (drawn
    after Pass 0, so Pass 0's geometry IS visible) was tried: bit_cnt[2]
    resolved cleanly, but _115_/_080_ just relocated their coll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
2026-08-14 nrow_fm: document 2 more failed attempts at the remaining 3 shorts (38.19/38.20)
    Both were tried per user request and reverted after regressing:
    - 38.19: reuse a per-row-local net's own existing pin X (row_trunk_xmin)
    as the spine's row-crossing candidate instead of an independent
    find_row_clear_x search. Naive version (no live check) regressed
    3->7 shorts. Added row_clear_self_excluding (excludes the net's own
    net_shapes from the check) -- result was IDENTICAL to baseline (3
    shorts, 18 jogs unchanged), since the existing pin column almost
    always has a genuine foreign M2 obstruction anyway. Kept the more
    correct self-excluding check since it's a net-neutral improvement.
    - 38.20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
2026-08-14 nrow_fm: document 38.21 fundamental-rework attempt (static stub-overlap check) -- reverted, root cause is draw_jog fallback's own unchecked departure leg
2026-08-14 nrow_fm: fix draw_jog departure-leg safety (38.22) -- shorts 3->1, DRC 0
    - reinstate static_stub_spans/static_stub_blocked (order-independent
    stub-overlap check) in channel_clear/row_clear
    - claim_track_near gains extra_ok() so draw_jog's near_y fallback only
    claims a track whose departure leg is itself verified clear (live +
    static), instead of an unconditional unchecked leg; falls back to
    the old behavior with a warning (not a crash) if none qualifies
    - root fix: Pass 0's row-crossing search (find_row_clear_x) now also
    requires the SAME x to land cleanly in the next channel, chosen via
    extra_ok, instead of discovering the problem only after cur_x is
    fixed -- eliminates the ch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
    [gen_err_report_nrow_fm.py]
2026-08-14 nrow_fm: add dedicated ERR-layer highlight for remaining _055_/bit_cnt[1] short
    Distinguishes this short's root cause from the two 38.22 fixed: real
    pin-X coincidence (_423_.B / _464_.Q both at x=494.1, not a routing
    choice) plus bit_cnt[1]'s own stub spanning ~182um (nearly the whole
    channel) at that column, with channel1 at 100% track capacity -- no
    track has a clear departure leg for _055_'s jog to escape through.
2026-08-14 nrow_fm: add track-reuse tier to draw_jog fallback (38.23)
    - claim_track_near gains allow_claimed: when the exclusive-ownership
    search finds no track with a clear departure leg, retry allowing
    reuse of an already-claimed track, gated by a new m1_run_clear()
    live-geometry check (the M1 run must not physically overlap what
    the other net actually drew there)
    - GDS-verified audit (independent of net_shapes) confirmed real idle
    capacity: 9-24 fully unused tracks per channel
    - successfully reused a track for _371_.A's jog (previously a long
    unnecessary detour); no DRC/short regression
    - root-caused why _423_.B/_055_ still can't be fixed this way: it is
    boxed in by TWO immediately adj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
2026-08-14 nrow_fm: fix two boundary-case bugs in jog safety checks (38.24) -- shorts 1->0, ALL RESOLVED
    User proposed an early-jog route in KLayout (jog right after leaving
    the row, before climbing into the blocked zone) that appeared to
    contradict 38.23's conclusion. Live instrumentation found two
    independent floating-point/semantic boundary bugs, both making
    exactly-legal-minimum-spacing candidates register as blocked:
    1. channel_clear's M2 check used begin_shapes_rec_touching (boundary-
    touching counts as collision) instead of begin_shapes_rec_overlapping
    (requires real positive-area overlap) -- a candidate at exactly the
    legal 2.0um minimum gap was incorrectly rejected.
    2. static_stub_bl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
2026-08-18 DFFR: rename RST pin to RSTB (schematic/GDS sync), fix .lib generator active-low regression, add DFF PIN_META + regenerate LEF, resynthesize (v3)
    - LEF/TR-1um_STDCELL.gds remade: adds reset-less DFF cell, drops DFFS.
    - gen_lef.py: add PIN_META["DFF"], rename DFFR's RST pin -> RSTB to
    match the renamed GDS/schematic pin; regenerate TR-1um_STDCELL.lef.
    - TR1um_5_stdcell.lib: pin(RST)->pin(RSTB), clear:"!RST"->"!RSTB" (4 sites).
    - gen_liberty.py: FF_CELLS RST->RSTB; ff_cell() gains active_low= to
    correctly emit Liberty's "!" inversion syntax -- fixes a latent bug
    where regenerating the .lib from this script would have silently
    reverted the earlier RST-polarity fix (script wasn't kept in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
    [DFF.sch, DFFR.sch]
2026-08-18 stdcell_behavioral_stubs.v: DFFR RST->RSTB (active-low), add DFF stub
    Keeps the iverilog behavioral cell models in sync with the RSTB rename
    (design_notes.md 39.2) and the new reset-less DFF cell (39.1). Verified
    every cell type instantiated by src/i2c_slave_async_net_v3.v (AND2_X1,
    DFFR, INV_X1, MUX2, NAND2/3/4, NOR2/3/4, OR2/3/4) has a matching stub
    module, and that DFFR's port list (.CK/.D/.Q/.QB/.RSTB) matches the
    netlist's instance connections exactly. iverilog itself is not available
    in this sandbox, so the actual simulation run must be done by the user
    locally.
    [stdcell_behavioral_stubs.v]
2026-08-18 i2c_slave_async_net_v3.v: rename high-FO reset pre-terms _085_/_179_ -> RSTB1/RSTB2
    Pure rename, no structural change (verified: identical cell/instance
    list before and after). _085_ (~rst_n, FO=24, feeds SCL-domain per-DFFR
    NOR2 reset gates) -> RSTB1; _179_ (start_pulse-derived NOR2 term, FO=24,
    same fanin group) -> RSTB2. Makes these two high-fanout nets identifiable
    for future FORCE_JOG_NETS / priority-routing treatment when v3 eventually
    goes through P&R.
2026-08-18 v4: row-aware BUF_X1 insertion for scl/scl_n, route to 0 shorts (section 40)
    - script/insert_row_buffers.py (new): row-aware buffer insertion, replacing
    insert_buffers.py's row-unaware round-robin split. Groups scl/scl_n's
    DFFR.CK sinks by row (via a reference fm_multiway_partition pass on
    i2c_slave_async_net_v3.v), inserts one BUF_X1 per row that has sinks,
    redirects to new row-local nets (scl_row0..3, scl_n_row1/2). Output:
    src/i2c_slave_async_net_v4.v. Saves the full instance->row assignment to
    LEF/row_assignment_v4.json so it can be REUSED (not recomputed) by the
    real placement pass -- re-running fm_multiway_partition on the buffered
    netlist from scratch was found to resh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
    [DEL1.sch]
2026-08-18 DEL1 fixed (M1 spacing), regenerate placement/route for both pipelines -- v4 now 0 DRC / 0 shorts
    User supplied a corrected TR-1um_STDCELL.gds: DEL1's internal M1 spacing
    violation is fixed (pin geometry/cell size unchanged, verified -- no LEF
    regen or re-placement needed structurally, just re-copy the fixed
    physical cell). Regenerated placement GDS + re-routed both pipelines
    (original netlist, and v4's row-buffered scl/scl_n + RSTB1/RSTB2
    per-row-local nets) against the fixed library.
    Original netlist pipeline: still 0 DRC / 0 shorts (unchanged).
    v4 pipeline: now 0 DRC / 0 shorts (previously the only remaining issue
    was this DEL1 defect, confirmed pre-existing/out of routing's control in
    s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
2026-08-18 Add channel-height Y-compression post-process (section 41)
    - route_channels_nrow_fm.py: added channel_usage_path (dumps per-channel
    used_tracks/budget_tracks) and ch_heights override. Also tried a
    geometry-based real-extent measurement first (max_signal_geom_y_um) --
    discarded: TAP2 power-mesh straps always span the full channel height
    by construction, and per-row-local nets' stubs legitimately extend past
    the channel into the row above, so raw geometry probing always reports
    "fully used" regardless of true headroom. Track-count (next_free_idx)
    is the reliable signal.
    - gen_placement_gds_nrow_fm.py: added ch_heights override (must stay in
    sync with route_channels_nrow_fm.py's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
2026-08-18 Regenerate all 4 layout variants against updated TR-1um_STDCELL.gds
    User supplied another corrected STDCELL library (all 20 cells, sizes and
    pin geometry unchanged, no isolated-cell DRC violations found -- likely
    an internal fix similar in spirit to the earlier DEL1 correction).
    Re-copied the fresh cells into placement GDS and re-routed all 4 tracked
    layout variants: original-netlist normal, original-netlist compressed,
    v4 (row-buffered scl/scl_n) normal, v4 compressed. All 4 re-verified:
    0 DRC violations, 0 connectivity shorts. Channel-compression heights
    unchanged (pin geometry didn't move). Error/jog highlight GDS
    regenerated for all 4.
2026-08-18 Fix NOR2/AND2_X1 gate duplication (opt_merge) and DFFR RB/RSTB pin mismatch bug
    - gen_liberty/yosys synth: added opt_merge -share_all after abc, dedups
    24x NOR2(RSTB1,RSTB2) -> 1 and 9x AND2_X1(busy,rst_n) -> 1
    (v5 netlist, 175->144 instances). Formally cross-checked DFFR fanout
    sets match v3 exactly.
    - CRITICAL FIX: gen_placement_nrow_fm.py's attach_pins() was silently
    dropping every DFFR reset-pin connection in every prior layout
    (LEF pin name 'RB' vs netlist/.lib pin name 'RSTB' never matched).
    Added PIN_NAME_ALIASES translation. All previously-delivered GDS
    files had a floating async reset network despite passing DRC/
    connectivity checks (those checks never examined the m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
2026-08-18 Regenerate LEF from GDS with DFFR pin relabeled RB->RSTB, re-verify v6
    User relabeled the DFFR reset-pin GDS marker from RB to RSTB directly
    (matching the .lib/netlist side), making the section-42.5 pin-name
    alias workaround unnecessary (kept as a harmless no-op fallback).
    Confirmed the pin's RECT geometry is byte-identical, purely a label
    change. Regenerated TR-1um_STDCELL.lef (23 macros, DFFR now natively
    exposes RSTB). DEL1/TAP2/TAP3 OBS polygons also picked up unrelated
    geometry updates from the refreshed GDS -- confirmed these don't
    affect routing (OBS is never consulted by the router). Re-ran v6
    placement/routing/DRC/connectivity end to end against the new LEF:
    identical result to befo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
2026-08-18 Fix sda_in/scl per-row-local collision; document shreg[1]/_071_ residual
    Per-row-local step 1 (pin -> dedicated track) now splits into two legs:
    fixed-X inside the row (unchecked, same assumption as elsewhere), then
    a live-checked, draw_jog-based M2 jog once inside the open channel --
    replacing the previous M1-jog-at-pin-height attempt, which almost
    always failed to find clearance in a row packed with unrelated cell
    M1. Resolves the sda_in/scl collision cleanly (0 DRC regression).
    Added register_via_x calls to per-row-local trunk/spine landings so
    FORCE_JOG_NETS's via_x_clear can see them.
    Root-caused shreg[1]/_071_: draw_jog's claim_track_near can land its
    jog_y outside the Y-range the ca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
2026-08-18 Add per-step layout checkpoints to router; document P&R pipeline stages (design_notes 43)
    route_channels_nrow_fm.py: add optional checkpoint_dir/checkpoint_prefix
    kwargs to main() that write an intermediate GDS after each of the 5
    internal drawing passes (TAP power mesh, per-row-local, high-FO+row-
    only+adjacent-pair, spanning, FORCE_JOG_NETS). Purely additive, no-op
    when checkpoint_dir is not given.
    run_route_v6_checkpoints.py: new driver reproducing the exact v6
    priority-net configuration (per_row_local_nets/force_jog_nets/
    ch_heights from design_notes 42.6/42.9) with checkpointing enabled.
    Re-ran the full v6 pipeline; result is unchanged from the known-good
    baseline (0 DRC violations, 1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
2026-08-18 Highlight per-step free channel-track resource on a dedicated layer per step (design_notes 43.3)
    route_channels_nrow_fm.py: checkpoint() now also draws every channel
    track NOT YET in channel_used_x (i.e. still free for a later pass) as
    a thin box on non-fab layer (258, N), N = that checkpoint's step
    number -- lets free capacity be inspected/compared per step in
    KLayout by toggling each step's datatype independently.
    Drawn into a layout.dup() scratch copy only, never into the real
    layout/top -- confirmed the real out_gds carries no layer-258
    geometry and DRC/connectivity results are unchanged (0 violations,
    161/162 nets, same single shreg[1]/_071_ short) after this change.
    v6 free-track cou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
2026-08-18 Redefine channel-free highlight from track bookkeeping to real M1 geometry (design_notes 43.5)
    checkpoint() now computes the (258, N) free-capacity highlight from
    the ACTUAL drawn M1 in a layout.dup() (per-track Y-band, full channel
    width minus merged real M1), instead of the channel_used_x
    reservation registry. The old bookkeeping-based version couldn't
    distinguish 'reserved for a not-yet-drawn later pass' from
    'genuinely free', and undercounted idle capacity since every net's
    M1 trunk only spans its own xmin..xmax, never the full channel width
    (design_notes 38.23's '9-24 idle tracks per channel' finding).
    At the final checkpoint (after all passes), this highlight is now a
    trustworthy meas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
2026-08-18 Fix shreg[1]/_071_ short: try track reuse before fresh claim in draw_jog (design_notes 43.6)
    Flip draw_jog's near_y track-claim priority: try reusing an idle
    stretch of an already-claimed track FIRST (allow_claimed=True +
    departure_leg_and_m1_ok), falling back to claiming a fresh track only
    if no safe reusable stretch is found nearby. Same safety checks as
    before (channel_clear + m1_run_clear), only the trial order changed.
    Motivated by the user's goal of maximizing leftover free M1 channel
    capacity: the old fresh-first order would search increasingly far
    from target_idx whenever the nearest reusable idle stretch was
    skipped, and find_channel_clear_x's checks get stricter with search
    distan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
2026-08-18 Compress v6 channel heights post-process (design_notes 43.7)
    Applied the existing compress_channels_nrow_fm.py (section 41) to v6:
    measures real per-channel track usage at the original CH_HEIGHTS,
    shrinks each channel to used-tracks + 1 margin track (never larger
    than original), then re-places/re-routes at the new heights.
    ch0 98->96um, ch4 100->40um (only 9/25 tracks used); ch1-3 stayed at
    their original height since track usage now exactly fills budget
    (a side effect of 43.6's track-reuse-first fix). Core height
    1181.2um -> 1119.2um (-62um, -5.2%).
    Re-verified DRC (0 violations) and connectivity (162/162 nets, 0
    shorts) at the new, shorter core height -- fully clean, matching
    43.6's resu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
2026-08-18 Compress v6 to minimum necessary channel height, margin_tracks=0 (design_notes 43.8)
    Re-ran compress_channels_nrow_fm.py with margin_tracks=0 (no safety
    headroom) instead of 43.7's default 1-track margin, then verified
    fixed-point convergence (re-measuring and compressing again from the
    new heights produces no further reduction).
    ch0 98->92um (23/23 tracks, zero slack), ch4 100->36um (9/9 tracks,
    zero slack); ch1-3 unchanged (were already at exactly their used
    track count even at the original height). Core height
    1181.2um -> 1111.2um (-70.0um, -5.9% vs the original uncompressed
    height; -8um vs 43.7's margin=1 result).
    shorts)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
2026-08-18 Post-route geometric Y-compaction, no re-routing (design_notes 44)
    New script/squeeze_channels_nrow_fm.py: takes an already-routed GDS
    and physically removes track slices that are neither claimed
    (channel_used_x) nor a required HIGH_FO_GUARD_TRACKS/
    PER_ROW_GUARD_TRACKS guard slot, then applies a piecewise-linear
    Y-remap (identity in rows and kept track slices, zero-width through
    removed slices) to every top-level shape and cell/via instance.
    Safety: compaction can make two tracks index-adjacent that were never
    originally adjacent, and collides()'s MIN_VIA_X_SEP check was only
    ever validated against ORIGINAL neighbors at claim time. Re-validates
    every newly-adjacent pair that both carry rea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
2026-08-18 Refresh v6 step-by-step layout set for animation (design_notes 43/44)
    Regenerated steps 0-6 with the current router (post-43.6 track-reuse
    priority fix) at the original CH_HEIGHTS, confirming 0 DRC / 0 shorts
    end to end. Added step7 (43.8 minheight compression) and step8 (44
    geometric squeeze) so the full 9-step sequence tells the complete
    story from placement through both compression stages, per user
    request for a step-by-step animation. Added steps_v6/README.txt
    describing each step and its core height.
2026-08-18 Section 45: row-count/N_GAPS area comparison, 2 permanent router fixes
    Reference exploration (not the production deliverable -- v6, 4-row/
    5-channel, stays the signed-off design): re-ran the full placement->
    route->minheight-compression->squeeze pipeline for 2-row/3-channel and
    3-row/4-channel variants of the same v6 netlist, to compare core area
    against v6 (1620.0 x 891.2um, 1.4437 mm^2, 162/162 nets clean).
    Results (design_notes.md section 45):
    - 3-row/4ch, N_GAPS=2 (row width 2424.6um): 1.8582 mm^2 (128.7%)
    - 3-row/4ch, N_GAPS=1 (row width 1620.0um, same as v6): 1.2610 mm^2
    (87.3%, smallest of all variants)
    - 2-row/3ch, N_GAPS=1 (row width 2424.6um): 1.5944 mm^2 (110.4%)
    All th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
2026-08-26 Top-level FRAME/GIO integration, LVS clean-up, and project cleanup
    - Add VDD/VSS boundary-pin markers + labels to core cell (M1PIN/M2PIN
    convention required for LVS port recognition; VSS ended up handled
    by the deck's global net declaration instead)
    - Fix GIO/OUT2 mis-wiring (was incorrectly tied to VSS instead of
    being left unconnected per schematic intent) in route_gio_core.py
    - Reach LVS-clean at both the core-cell-standalone and top-level
    (tr_1um_i2c_slave_async) levels (design_notes.md section 75)
    - Add SCRIPTS.md describing the current script/ pipeline
    - Remove ~52 superseded/obsolete scripts (row/2row/2row_fm-era,
    v2/v3 RTL model+tests, one-off debug/highlight tools, old rou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
    [AND2_X1.sch, BUFTH.sch, BUFTH_X1_AC.sch, BUF_X1.sch, DFFRB.sch, FILL2.sch, FILL3.sch, INV_X1.sch]
2026-08-29 V9: DFFS-enabled core re-route, GIO re-integration, chip-level DRC/LVS clean
    Covers the V8->V9 work accumulated since the last commit (design_notes
    §77-§86), culminating in a user-confirmed clean chip-level DRC/LVS run.
    V8 (RTL fix): walking-one race fix + sda_oe polarity inversion,
    DFFS-less net synthesized and placed/routed to DRC 0 / short 0
    (layout/step8/v8_step_9_power_pins_added.gds).
    V9 (physical re-implementation): core re-placed/re-routed with DFFS
    permitted, GIO<->core re-wired and power mesh rebuilt
    (script/route_gio_core_v9.py), DRC-clean baseline confirmed
    (design_notes §79) and finalized to src/tr_1um_i2c_slave_async.gds.
    Chip-level LVS bring-up (design_notes §80-85), th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
    [AND3_X1.sch, AND4_X1.sch, DFFRS.sch, DFFS.sch, IO_AC.sch, IO_DC.sch, XNOR2.sch, XOR2.sch]
2026-08-29 IRSIM: regenerate .sim from v9 LVS-clean spice (gen_irsim_sim_v9.py)
    - New script/gen_irsim_sim_v9.py parses schematic/tr_1um_i2c_slave_async_v9_lvs.spice
    (the chip-level DRC/LVS-clean reference) instead of the old KLayout-extraction
    source (src/tr_1um_i2c_slave_async.extracted).
    - Structural (not hardcoded-path) lookup of the SDA pad drive-gate node for the
    synthetic weak pull-up device.
    - insert_sda_hiz_inverter() workaround deliberately dropped (obsolete: RTL-level
    sda_oe polarity fixed in V8+).
    - irsim/tr_1um_i2c_slave_async.sim regenerated: 2076 real + 1 synthetic pull-up
    = 2077 transistors, 844 nodes (vs old 2074+3=2077 / 863 -- consistent).
    - design_notes.md $87, irsim/READM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
    [gen_irsim_sim_v9.py]
2026-08-29 IRSIM: regenerate .cmd stimulus files for v9 netlist (gen_irsim_cmd_v9.py)
    - New script/gen_irsim_cmd_v9.py re-derives all node-name constants for the
    new .sim (top-level signals positionally from the LVS spice's own
    instantiation lines; DFFRB 24+9 reset-group instance paths and 4 row-clock
    nets by grepping every DFFRB instance line's RSTB/CK fields directly).
    - Bus-functional-model logic (CmdGen class) copied unchanged -- it's a
    mechanical MyHDL-testbench translation independent of net names.
    - Verified: all 63 nodes referenced across the 3 generated .cmd files exist
    in tr_1um_i2c_slave_async.sim (0 missing).
    - User confirmed real irsim 9.7.121 load of the new .sim matches expecte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
    [gen_irsim_cmd_v9.py]
2026-08-29 IRSIM: fix negative-test SDA settle margin, drop quit from run_batch.sh
    Real batch run (design_notes.md $89) analysis:
    - reset_check + WRITE transaction (first START): fully correct end-to-end
    (ACKs, addr_match/rw, rx_data==0xA5, busy clears).
    - READ transaction (2nd, non-first START): addr_match/rw never assert --
    suspect force_release_gated()'s clock-net forcing may be unnecessary/
    harmful on this netlist (reset_check itself resolved cleanly with no QS
    forcing at all, unlike the old .sim).
    - negative test's inline NACK check used 1 stepsize instead of the
    established SDA_RELEASE_SETTLE_NS margin (carried over unfixed from the
    old script) -- likely a probe-too-early artifact, no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
    [gen_irsim_cmd_v9.py]
2026-08-29 IRSIM: add irsim_test_main_noforce.cmd experiment (Group-A force skipped)
    - gen_irsim_cmd_v9.py's start() now takes group_a_mode ('gated'/'plain'/
    'none') to control how the non-first START handles Group-A DFFRB reset.
    Default 'gated' preserves the validated baseline irsim_test_main.cmd
    unchanged (diff shows only added comment lines).
    - New irsim_test_main_noforce.cmd uses group_a_mode='none' for the 2nd
    START, testing whether the old design's cold-X QM/QS workaround is even
    needed on v9's re-synthesized netlist (reset_check resolved cleanly with
    zero forcing, design_notes.md 89.1).
    - Confirmed via user's real re-run: fixed irsim_test_negative.cmd now
    passes (P13=1 NACK, addr_m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
    [gen_irsim_cmd_v9.py]
2026-08-29 IRSIM: isolate bit_cnt[0] reset race in force_release_gated(), add settle fix
    - irsim_debug_read_addr.cmd real run pinpointed the READ-transaction
    failure to a single bit: right after the 2nd START's Group-A reset,
    bit_cnt[0] reads 1 (should be 0) while bit_cnt[1:2]/rw/addr_match/all
    of shreg -- sharing the identical row-clock net -- correctly read 0.
    This single stuck bit offsets bit_cnt by +1, causing the byte-complete/
    phase transition to fire one bit early against an incomplete shreg,
    explaining the observed no-ACK/rw-stuck-at-0 symptom exactly.
    - Hypothesis: bit_cnt[0], likely a self-referential toggle bit
    (D=NOT(Q)), raced because force_release_gated() released QS and the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
    [gen_irsim_cmd_v9.py]
2026-08-29 IRSIM: settle-insertion fix had no effect; add QS/QB/D probe instrumentation
    - Real run confirmed the 92.x settle fix produced BIT-IDENTICAL results
    (bit_cnt[0] still 1 right after the 2nd START's Group-A reset) --
    release-ordering race hypothesis disproven.
    - force_release_gated() now takes an optional probe= list, dumping it at
    3 points: right after forcing (clock+QS), right after releasing QS
    (clock still forced low), right after releasing clock too. start()
    threads this through as debug_probe=.
    - gen_irsim_debug_read_addr.py now probes bit_cnt[0]'s own DFFRB
    (x_270_) internals directly: QS (x2.x_270_.QS), QB (x2._147_[0], read
    off the instance line's own pin order), D (x2._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
    [gen_irsim_cmd_v9.py]
2026-08-29 IRSIM: root cause found -- force QM (master latch node) alongside QS
    - 3-point QS/QB/D probe pinpointed exactly when bit_cnt[0] corrupts:
    correct through forcing and through releasing QS (clock still forced
    low), but flips 0->1 the INSTANT the clock nets are released back to
    the real network.
    - Root cause: force_release_gated()/force_release() only ever forced QS
    (slave latch node), never QM (master latch node). Once the clock
    returns to a level where QM<->QS is transparent again, QM's own never-
    reset STALE value overwrites the QS value we just forced. Every
    Group-A/B register has this same latent issue -- bit_cnt[0] just
    happened to be the one whose stale QM (1) differed fr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
    [gen_irsim_cmd_v9.py]
2026-08-29 IRSIM: force clock HIGH not LOW in force_release_gated() -- QM needs CK=1 to latch
    - 3-point probe with QM added showed QM flips back to 1 immediately after
    release, even while the clock nets are still forced LOW (QS stays 0
    correctly through this same window).
    - Root cause: DFFRB's master latch (QM, via net2's CKP/CKB pass-gates
    MM1/MM7) is directly transparent to D whenever CK=0 -- there's no
    self-reinforcing loop protecting QM the way net5=NOT(QB) protects QS.
    Forcing QM while CK=0 is a no-op the instant it's released.
    - Fix: force the row-clock nets HIGH (CK=1) instead of LOW. At CK=1 the
    master (QM) is opaque/latched (external force sticks) and QM<->QS is
    transparent (QS f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
    [gen_irsim_cmd_v9.py]
2026-08-29 IRSIM: confirmed fix works -- READ transaction addr_match/rw/ACK now correct
    - irsim_debug_read_addr5.log: all 3 probe points show QS=0 QM=0
    consistently (force, QM/QS release, clock release) -- QM finally stays
    reset through the whole sequence.
    - bit_cnt correctly counts 0..7 across the 8 READ address bits (0xA1),
    wrapping to 0 exactly at the 8th bit (matching the WRITE transaction's
    known-good timing) instead of one bit early.
    - addr_match=1, rw=1, ACK (P13=0) all correct for the READ address --
    the 89-95 investigation (force_release_gated only forcing QS -> also
    forcing QM -> clock polarity needing HIGH not LOW) is resolved.
    - design_notes.md $96. Next: user to run the full ir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
2026-08-29 IRSIM: self-checking testbench equivalent to src/i2c_slave_async_tb.v
    - gen_irsim_cmd_v9.py: CmdGen now records every d()/checked_dump() call
    into an ordered self.checks list (backward compatible -- existing
    scripts unaffected). New checked_dump(label, expect, group=) records
    expected {node: 0/1} values alongside the dump.
    - New script/gen_irsim_verilog_equiv_tb.py: builds irsim/irsim_tb.cmd,
    a single combined run mirroring i2c_slave_async_tb.v's exact 3
    scenarios (write 0xA5, read 0x3C, wrong-address NACK) and all 14
    checks in the same order, plus irsim/irsim_tb_expected.json recording
    expected values (including a 'groups' entry for the 8-bit read-byte
    reconstruction, mirror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
    [check_irsim_tb_log.py, gen_irsim_cmd_v9.py, gen_irsim_verilog_equiv_tb.py]
2026-08-29 IRSIM: real-hardware confirmation -- irsim_tb.cmd all 14 checks PASS
    check_irsim_tb_log.py against the real irsim_tb.log run: 'All 14 checks
    PASSED'. Confirms the v9 chip-level netlist's IRSIM switch-level
    simulation matches src/i2c_slave_async_tb.v / i2c_slave_async_net_tb.v's
    RTL/gate-level Verilog simulation results across all 3 scenarios
    (write/read/wrong-address) and all 14 checks. Closes out the design_notes
    87-99 IRSIM re-verification effort.
    design_notes.md $99.
2026-08-29 irsim: format checker output like Verilog tb, add run_tb.sh one-shot runner
    check_irsim_tb_log.py:
    - parse_log() now captures each dump block's closing 'time = ...' value
    and returns (time_str, {node: value}) tuples instead of bare dicts.
    - New fmt_line() prints '[t=<time>] OK:'/'FAIL:' with the message
    right-justified to MSG_FIELD_WIDTH=65, matching
    src/i2c_slave_async_tb.v's $display("[t=%0t] %s: %s", ...) style
    exactly (verified byte-for-byte against the user's real iverilog/vvp
    run output).
    - Group-synthesized checks (e.g. 'read byte == 0x3C', reconstructed
    from 8 per-bit samples) used to print after all other headline
    checks; now tagged with their originating index in chec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
    [check_irsim_tb_log.py]
2026-08-29 docs+cleanup: update logic_cells_mapping.md/SCRIPTS.md/README.md to v9, remove stale v7-era files
    logic_cells_mapping.md: re-derived from the actual current netlist
    (i2c_slave_async_net_v9_rowbuf.v, 135 instances) and LEF (29 macros, up
    from 23 -- AND3_X1/AND4_X1/XOR2/XNOR2/DFFS gained physical LEF/GDS since
    this doc was last touched, though still unused in synthesis; DEL2/DEL4
    remain the only Liberty-only placeholders). Corrected the BUFTH note:
    the real layout/LVS netlist still has 2 real BUFTH instances -- only
    the IRSIM .sim model substitutes BUF_X1, due to a confirmed permanent
    limitation of IRSIM's ternary switch-level solver, not a silicon
    defect. Added a note on DFFRB's QM/QS asymmet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
2026-08-30 fix: v9 instance count was undercounted (135->137, XOR2/XNOR2 missed by grep)
    logic_cells_mapping.md/SCRIPTS.md/design_notes.md all said
    i2c_slave_async_net_v9_rowbuf.v has 135 instances. The regex used to
    recount it after the earlier cleanup pass omitted XOR2/XNOR2 from its
    cell-type alternation, silently dropping the 1 XOR2 + 1 XNOR2 instance
    that are actually present and used -- correct total is 137. Re-verified
    with a looser regex that matches any instantiation line directly.
    Corrected the cell usage table, the 'AND3_X1/XOR2/XNOR2/DFFS unused'
    claim (only AND3_X1 and DFFS are actually unused; AND4_X1/XOR2/XNOR2
    each appear once), and every instance-count mention across the three
    docs.
    d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
2026-08-31 RING_OSC integration: physical routing, LVS reference netlist, core FILL2 fix
    RING_OSC (two 97-stage ring oscillators) integrated into
    tr_1um_i2c_slave_async, driven end-to-end by real DRC/LVS runs against
    the actual layout (klayout.db-based analysis of the shared
    .lyrdb/.lvsdb, no guessing):
    - script/place_ring_osc.py, gen_lef_ring_osc.py: placement + LEF
    generation for the RING_OSC macro.
    - script/route_ring_osc_power_v9.py: VDD/VSS power routing.
    - script/route_ring_osc_signals_v9.py: OUT/OUTD/ENB signal routing,
    through 4 real-DRC/visual-review-driven revisions -- final state
    routes OUT->OUT10, OUTD->OUT9 (OSS_FRAME_GIO's own driver-input pins,
    not the raw P9/P10 bond pads direc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
    [INV3D.sch, RING_OSC.sch]
2026-08-31 Add OpenSUSI logo (M2 digitized art) + PTECT keepout resolution
    - script/place_opensusi_logo.py: digitizes uploads/OPENSUSIcolor_a.png
    into a pixel-art M2 cell (OPENSUSI_LOGO) and places it centered in
    the DRC-safe clear space between the core and RING_OSC. Uses a
    uniform grid, pitch = M2 Wmin(3.0um) + Smin(2.0um) = 5.0um, so every
    isolated feature and gap satisfies M2 width/space DRC by
    construction. Clear-space envelope and logo aspect ratio (4.89:1,
    measured directly from the source PNG's ink bbox, not assumed) were
    both derived from direct klayout.db measurements, not guessed.
    Self-verified: 0 width/space violations on the logo alone, 0 newly
    introduced violations chip-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
2026-08-31 Add standalone RING_OSC ngspice testbench (extracted netlist)
    script/gen_ring_osc_tb.py generates a locally-runnable ngspice
    testbench for the standalone RING_OSC, confirmed working on real
    hardware (local ngspice run, log reviewed):
    - Source netlist: ring_osc/RING_OSC.extracted (layout-extracted, not
    schematic) per the user's explicit request, using the real TR-1um
    models (ip62_models, same ones used to calibrate irsim/TR-1um.prm).
    - One correction applied on top of the verbatim extraction: INV3D's
    AS/AD (and PS/PD) were swapped on both devices -- the extraction had
    put the antenna-diode-sized diffusion on the VDD/GND (supply) side,
    but the real layout has it on the Y (output) si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
    [gen_ring_osc_tb.py]
2026-08-31 docs: document RING_OSC integration in README/SCRIPTS, gitignore future TB raw files
    - .gitignore: ring_osc/TB/*.raw (ngspice rawfiles regenerated locally on
    every run, e.g. tb_ring_osc.raw was 18.5MB -- scoped so the existing
    irsim/*.raw precedent is unaffected).
    - README.md: new status-table row, deliverables, directory structure
    (ring_osc/, ring_osc/TB/), LVS section (core FILL2 fix, RING_OSC
    integration LVS), references index extended to design_notes.md
    §101-103.22, script count 52->59.
    - SCRIPTS.md: new section 11 documenting the 7 RING_OSC-related scripts
    (placement, LEF, power/signal routing, LVS netlist, OpenSUSI logo,
    standalone testbench), script count 52->59, noted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
2026-08-31 Add MPW-submission export pipeline (TR-1um_TEST3)
    - script/strip_orphan_cells.py: drops 5 dead unreferenced standard-cell
    definitions (AND3_X1/NAND4/DFF/TAP3/DFFS) left over from an earlier
    synthesis pass, producing ring_osc/tr_1um_i2c_slave_async_ringosc_clean.gds.
    Verified via full-layer XOR diff: 0 differences across all 36
    non-empty layers vs the pre-cleanup GDS -- the real design's geometry
    is untouched.
    - script/export_to_mpw_submission.py: copies the final chip GDS + LVS
    reference netlist into an OpenSUSI TR-1um_MPW_template-based
    submission repo (TR-1um_TEST3), renaming the real frame cell
    OSS_FRAME_GIO -> OSS_FRAME and dropping the now-redundant OSS_FRAME/
    OSS_FRAM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
2026-09-01 GIO pad reassignment: physical routing, DRC/LVS/IRSIM verification; OpenSUSI logo dot redesign
    - reroute_gio_pads_2026.py: physical implementation of the SCL/SDA-to-
    P1/P2 pad reassignment. tx_data[4] given a dedicated lane (R=857.0)
    with a cascade shift of 8 nets' lane radii to satisfy M2 parallel-run
    clearance (5.4um); HIZ1_VDD_tie converged to TIE_R=916.1 through
    successive real-DRC-driven fixes; OUT2_VSS_tie switched to a local M2
    patch; new ENB_rst_n_via added to restore RING_OSC.ENB<->rst_n/P15
    connectivity broken by the pad-reassignment redraw. DRC 0 violations
    confirmed on real KLayout.
    - gio_connections.json: fixed missing "net" fields for P7 (DIS) and
    OUT2 (VSS) tha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
    [gen_irsim_cmd_v9.py, gen_irsim_sim_v9.py, place_opensusi_logo_dots.py, reroute_gio_pads_2026.py]
2026-09-01 export_to_mpw_submission.py: point SRC_GDS at the current final GDS
    Re-pointed SRC_GDS from ring_osc/tr_1um_i2c_slave_async_ringosc_clean.gds
    (pre GIO-pad-reassignment) to
    ring_osc/tr_1um_i2c_slave_async_reassigned_logodots.gds (current final
    deliverable, design_notes.md §104-105). Top-cell structure is unchanged
    between the two files (confirmed before switching), so the existing
    orphan-drop + OSS_FRAME_GIO->OSS_FRAME rename logic applies unmodified.
    Used to re-export src/tr_1um_i2c_slave_async.gds/.cir into
    TR-1um_I2C_2026.
2026-09-01 design_notes.md: correct RING_OSC ring stage count (95 -> 97, prime)
    Sections 103.19 and 103.22 described each ring as "95 stages", counting
    only the main inverter chain (INV_X1 / INV3D, x1[0..94]/x54[0..94]).
    The real per-ring stage count, including the AND2_X1 ENB gate (part of
    the feedback loop) and the output buffer (INV_X1), is 97 -- a prime
    number, confirmed by gen_lvs_spice_ringosc_v9.py's own flattened
    instance count (194 = 97 x 2). Clarified both mentions accordingly.
2026-09-02 SPICE batch14: fix rx_data/read_byte capture bugs, reorganize row-buffer clock assignment
    - 108.14: rx_data capture MUX2 hold inputs were wired to the dangling
    net rx_data_r_N instead of the real rx_data_N feedback (netlist gen
    bug). Fixed in the sim-ready netlist.
    - 108.19/108.20: shreg's 7-stage DFFRB chain shared an overloaded
    _156__row3 clock buffer (14 loads) with rx_data, causing skew that
    corrupted '1' bits at the last_bit_pending transition edge. Moved
    shreg onto the previously-unused _156__row0 buffer.
    - 108.21/108.22: sda_oe_r shared scl_n_row0 with txreg_0/1/2 and
    intermittently failed to capture a settled '1' input. Added a new
    dedicated scl_n_row3 buffer for sda_oe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
2026-09-02 Commit remaining pending changes across RTL/netlist/script/layout files
    Includes prior uncommitted work in src/, schematic/, script/, LEF/,
    irsim/ alongside this session's design_notes.md STDCELL-count summary
    (108.25) and remaining ngspice/TB support files.
    Excluded via .gitignore: ngspice/TB/rx_capture_trace.txt (24MB),
    spice.log (2.3MB), and *.raw (9MB tb_chip_i2c.raw) -- regeneratable
    ngspice simulation byproducts, same precedent as ring_osc/TB/*.raw.
    Also excluded compiled vvp binaries and build logs under src/
    (sim_dbg9, sim_net, sim_net9, sim_rtl, Verilog.log).
2026-09-02 design_notes 108.25-108.28: STDCELL usage comparisons, MUXDFFRB/RSLATCH proposals, DFF group placement constraint script
    - 108.25: STDCELL instance-count diff between pre-session and current
    sim-ready netlist (only +1 BUF_X1 from this session's own changes).
    - 108.26: re-run the comparison against V5 (TR-1um_I2C_2026, the
    actual laid-out predecessor design) per user clarification of what
    'original state' means. DFFRB count identical (33) across V5->V9.
    - 108.27: proposed a new compound STDCELL, MUXDFFRB (MUX2 folded into
    DFFRB's D input), covering 19 sites in the current netlist where a
    single-fanout MUX2 feeds directly into one DFFRB -- documented
    internal wiring and the resulti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
2026-09-03 V10 core: MUXDFFRB/RSLATCH integration, re-placement/routing, LVS clean
    Migrates the core cell (i2c_slave_async_nrow_fm) netlist to use the two
    user-laid-out compound stdcells (MUXDFFRB = MUX2+DFFRB, RSLATCH =
    cross-coupled NOR2 pair), re-running placement and routing from scratch
    via the new run_v10_pipeline.py (dedup -> merge_muxdffrb_rslatch ->
    row-buffer insertion -> BUFTH insertion -> placement -> routing ->
    ripup/reroute). DRC 0 violations, 0 shorts.
    Completes the layout with channel squeeze + top-pin routing + VDD/GND
    top pins (run_v10_step7_squeeze_step8_toppins.py), then builds an LVS
    reference SPICE directly from the synthesized netlist (gen_lvs_spice_v10.py,
    no xschem round-trip;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
    [MUXDFFRB.sch, RSLATCH.sch]
2026-09-03 V10 core: channel4/0 re-squeeze, real-DRC CO-overlap fix, chip GIO feasibility check (108.52-108.54)
    - 108.52: row0/row3 self-collision fix removed need for channel0/4 guard
    reserves; core height 1073.9um -> 938.9um (channel4 recompressed).
    - 108.53: real KLayout DRC deck (drc.lydrc) found 1 V1.CO overlap on the
    U_SDA_TARGET.A->VDD tie via (row1 interior CO density too high for any
    hand-placed via within ~200um); rerouted the tie through channel2 to
    the existing TAP_1 VDD M2 strap instead. DRC/LVS clean end-to-end
    (custom checker + real production deck + LVS), user-confirmed.
    - 108.54: assemble_top_v10.py places the V10 core into the chip frame at
    V9's exact CORE_OFFSET -- geomet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
    [assemble_top_v10.py]
2026-09-03 V10チップレベル統合完了: GIO/RING_OSC結線、DRC/LVSクリーン、SPICE 14/14 PASS (design_notes 108.52-108.67)
    チップレベル統合パイプライン:
    - assemble_top_v10.py / assign_v10_gio_pads.py: V10コアのGIO組み込み配置
    ＋最適パッド再割当 (scipy.optimize.linear_sum_assignment、6レーン)
    - route_gio_core_v10.py: GIO<->コア結線ルータ (信号+電源)。本セッションで
    HIZ1のDISチェーン誤登録、HIZ7/OUT2のVDD/VSSバス取り違えを発見・修正
    (108.63) -- ダイ内部を貫くカーテシアン配線はRING_OSC/ロゴ/TAP列と
    衝突するため、DISチェーンと同じconnect_gio_to_gio()リング配線方式に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
    [assign_v10_gio_pads.py, finalize_chip_v10.py, gen_chip_sim_ready_v10.py, gen_chip_tb_batch14_v10.py, gen_chip_tb_v10.py, gen_lvs_spice_ringosc_v10.py]
2026-09-04 V10 pad reassignment revert to Option2, ENB routing fix, SPICE race-condition investigation, DIS/TXGATE production patch (design_notes 108.68-108.72)
    - 108.68: export V10 to TR-1um_I2C_2026 (export_to_mpw_submission_v10.py new)
    - 108.69: revert 108.57's lane-minimal pad assignment per user request;
    V9 pin-order reuse proven unroutable (14 lanes > budget), adopt
    user-proposed Option2 (physical pad number ascending == bit number
    ascending, P3..P6=bit0-3, P11..P14=bit4-7, 12 lanes = true minimum)
    - 108.70: fix real LVS error (P15 / P11,P12 mismatch) -- two stale
    hardcoded coordinates in finalize_chip_v10.py's ENB routing (rst_n
    lane-0 assumption, X=884.0 rise column) left over from 10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
    [assign_v10_gio_pads.py, export_to_mpw_submission_v10.py, finalize_chip_v10.py, gen_chip_tb_batch14_v10.py, gen_chip_tb_v10.py]
2026-09-04 design_notes 108.73: TR-1um_I2C_2026 CI LVS failure investigation and resolution
    Documents the investigation into the first-ever real netlist_only:false
    LVS comparison in TR-1um_I2C_2026's CI (all 10 prior runs only did
    extraction). Traced the "Netlists don't match" failure through: adding
    .lvsdb/log artifact upload to check.yml, analyzing the resulting
    .lvsdb via klayout.db.LayoutVsSchematic.xref() (found core + RING_OSC
    NoMatch, core showing 4 phantom NC_CORE_* ports), verifying byte-for-byte
    that the exported .cir matches the source repo's own LVS-clean reference
    SPICE, then reproducing locally against the exported files with the
    exact CI flags -- which passed cleanly. Root cause: OpenSUS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
2026-09-19 README: ここから育てた道具の正本は TR-1um_APRtools にあると冒頭に書いた
    clone した人が、第 1 世代の script/ を「いま手入れされている道具一式」と
    読んでしまわないように。書いたこと:
    * script/ は第 1 世代の原型で、当時のまま（成果物の再現用）
    * そこから 4 世代ぶん手を入れた一式は APRtools の apr/ に集約。
    **手入れが続いているのはそちらだけ**
    * 当時の写しは APRtools の legacy/async_i2c/ にも read-only で同梱
    * 新しい世代の設計例（I2C_2026 / TD4 / SCLK_SPI）へのリンク
    Claude-S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
